backtail/JOVE/Panel/jove fp mask.png

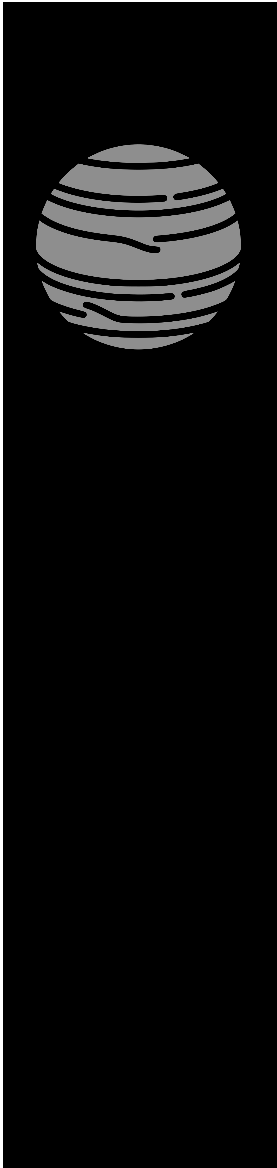
Panel/jove fp mask.png
