backtail/JOVE/Panel/jove fp silkscreen.png

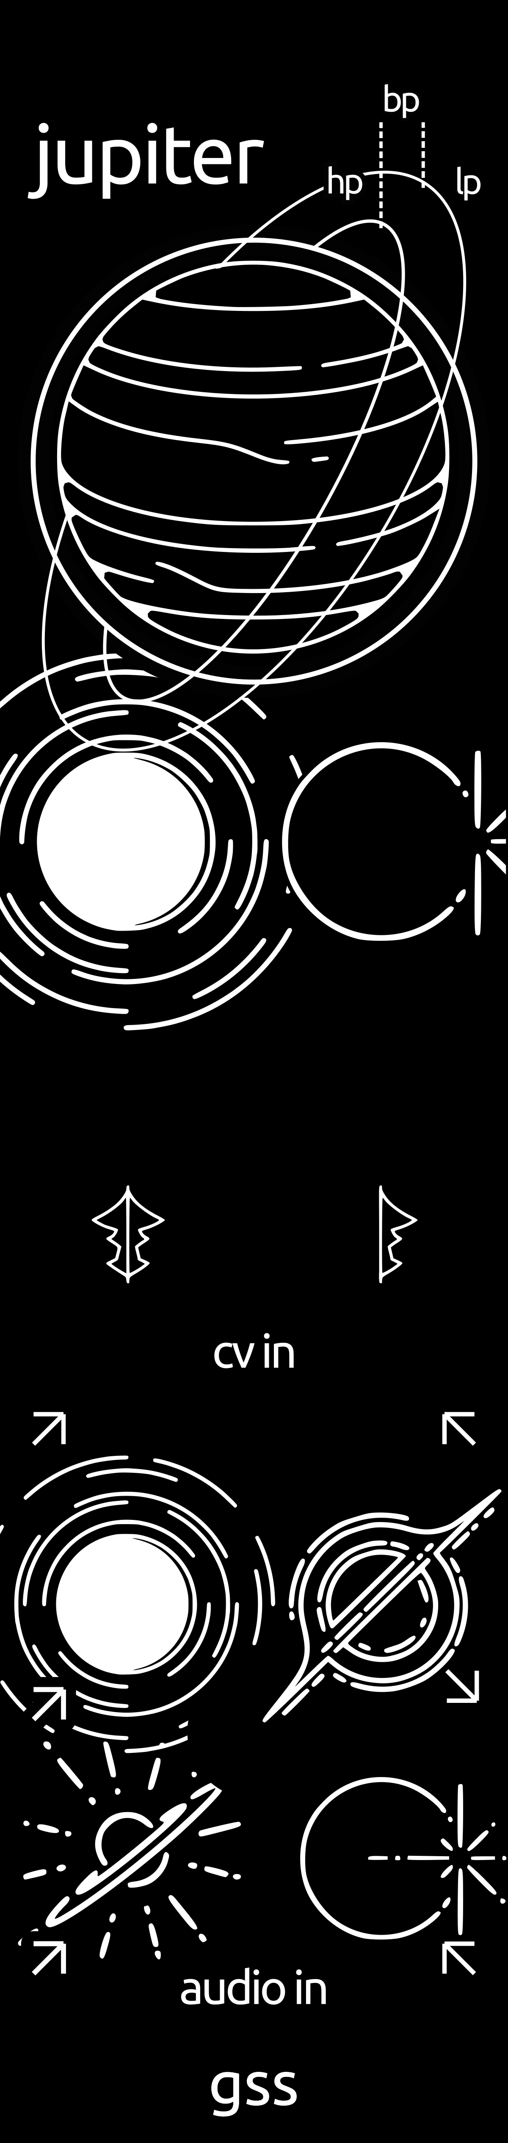
Panel/jove fp silkscreen.png
