backtail/JOVE/Panel/jove fp.png

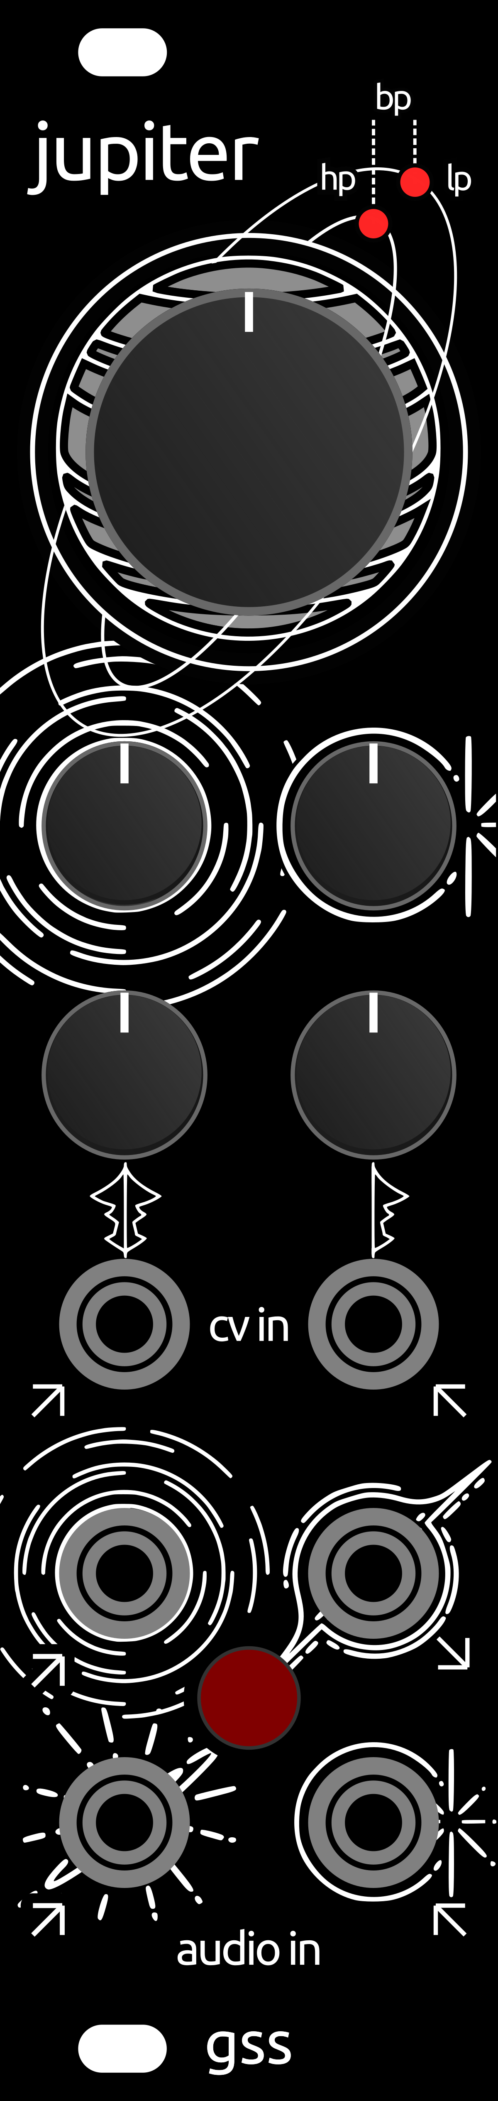
Panel/jove fp.png
