backtail/JOVE/Panel/jove.pdf

# jupiter

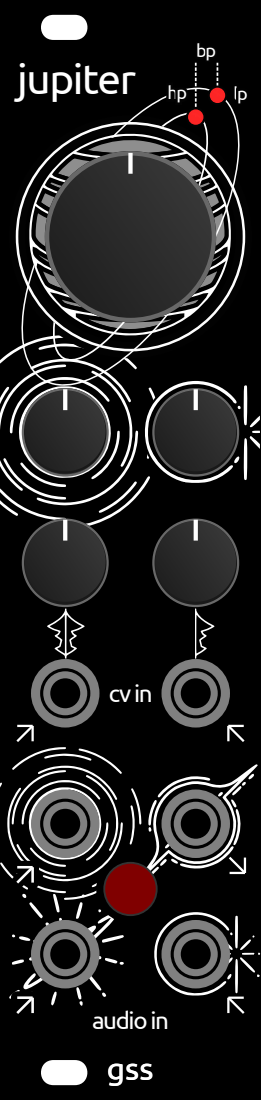
[picture p4: page 1]
gss; audio in
