backtail/JOVE/Jove.kicad_pcb

## KiCad design Jove.kicad_pcb (2024-10-23)

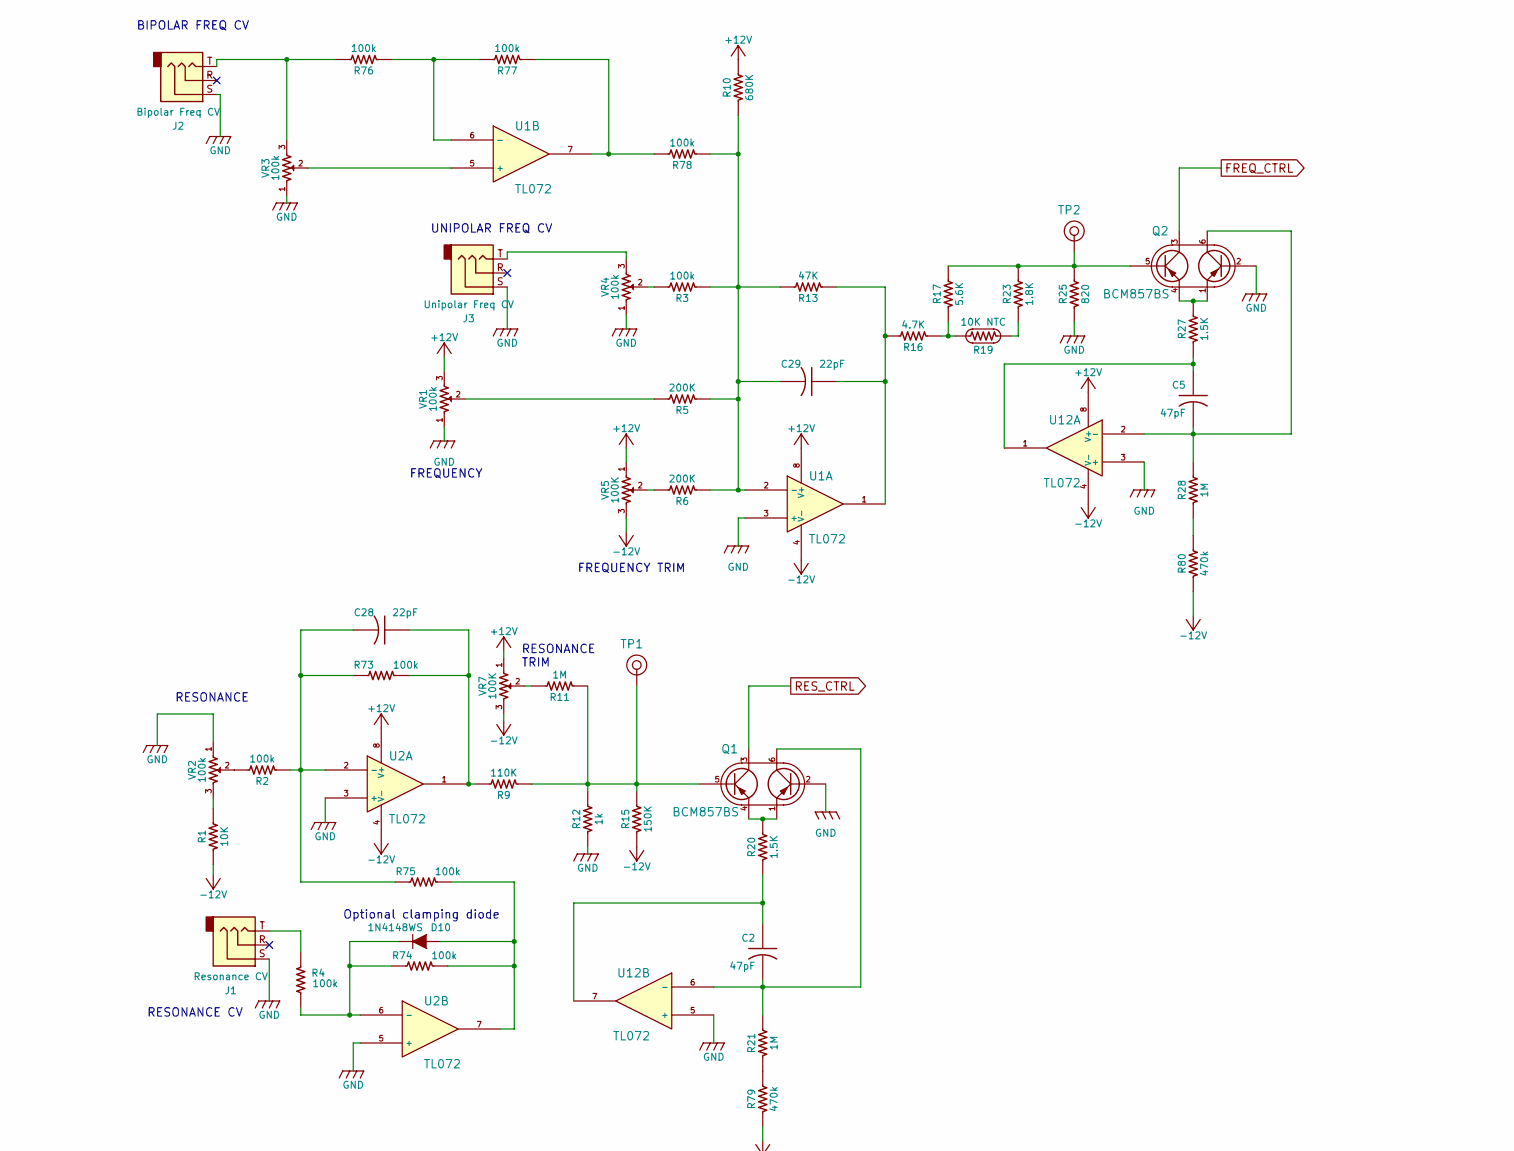
[picture p5: schematic Jove.kicad_sch, part in row 1, column 1]

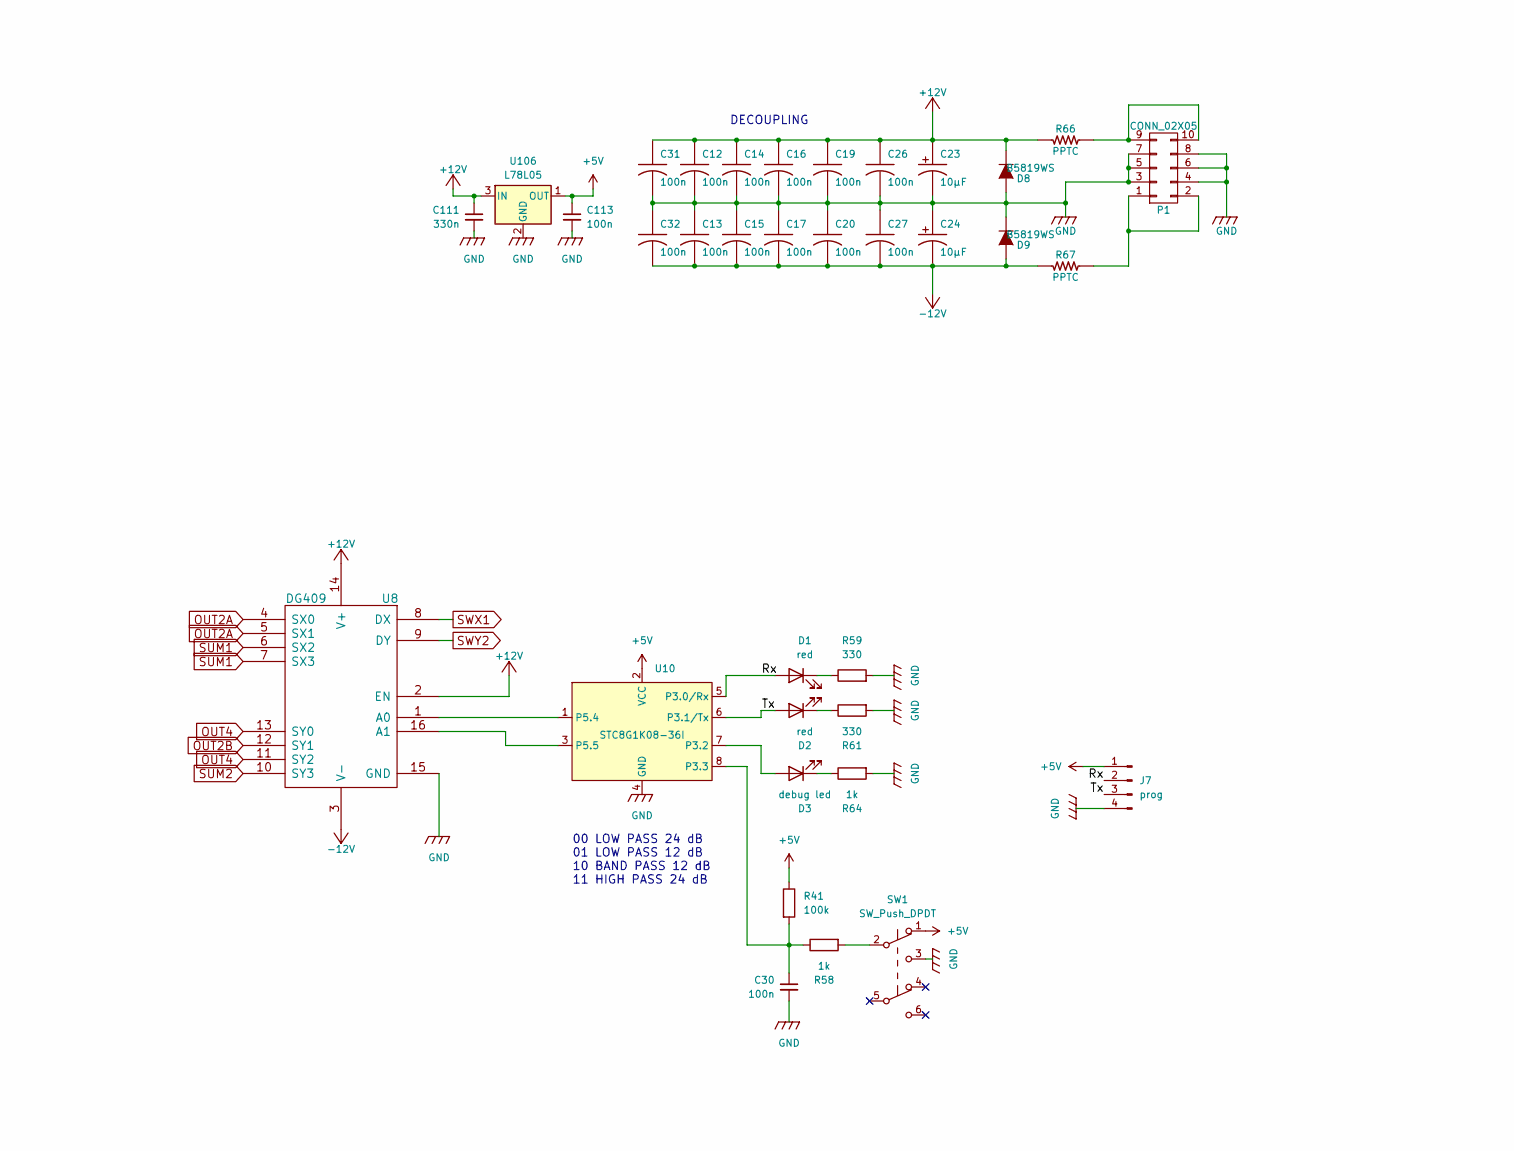
[picture p6: schematic Jove.kicad_sch, part in row 1, column 2]

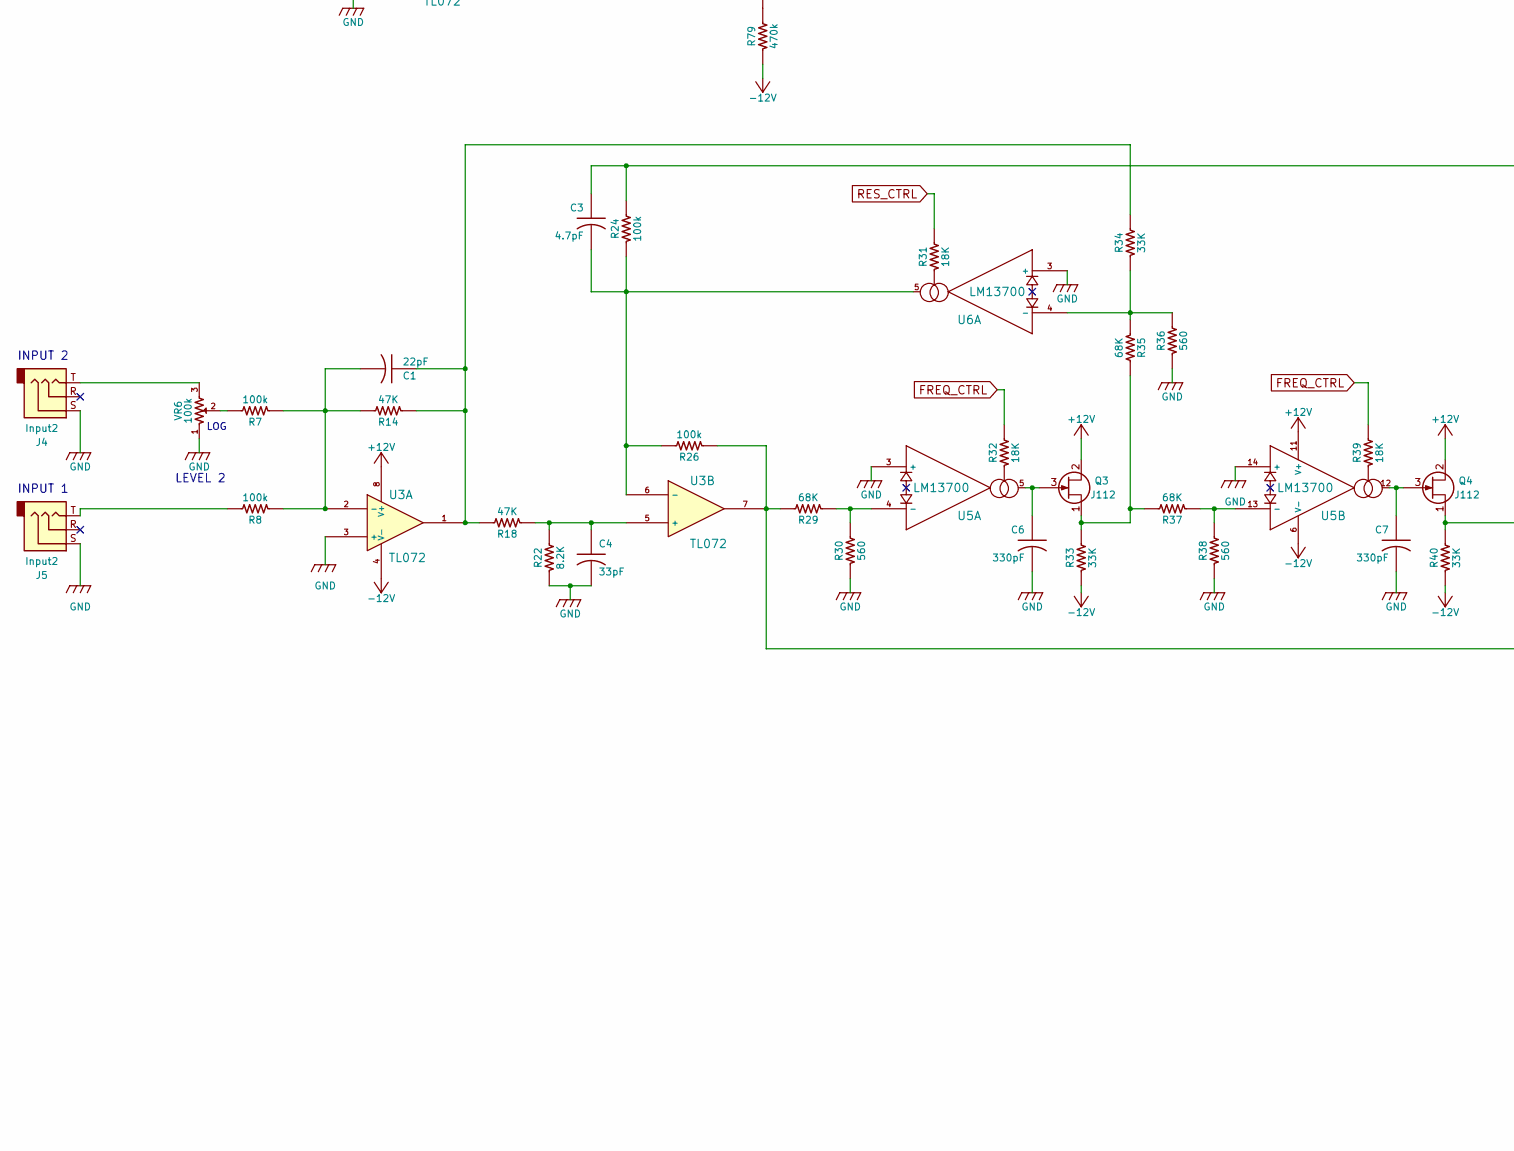
[picture p7: schematic Jove.kicad_sch, part in row 2, column 1]

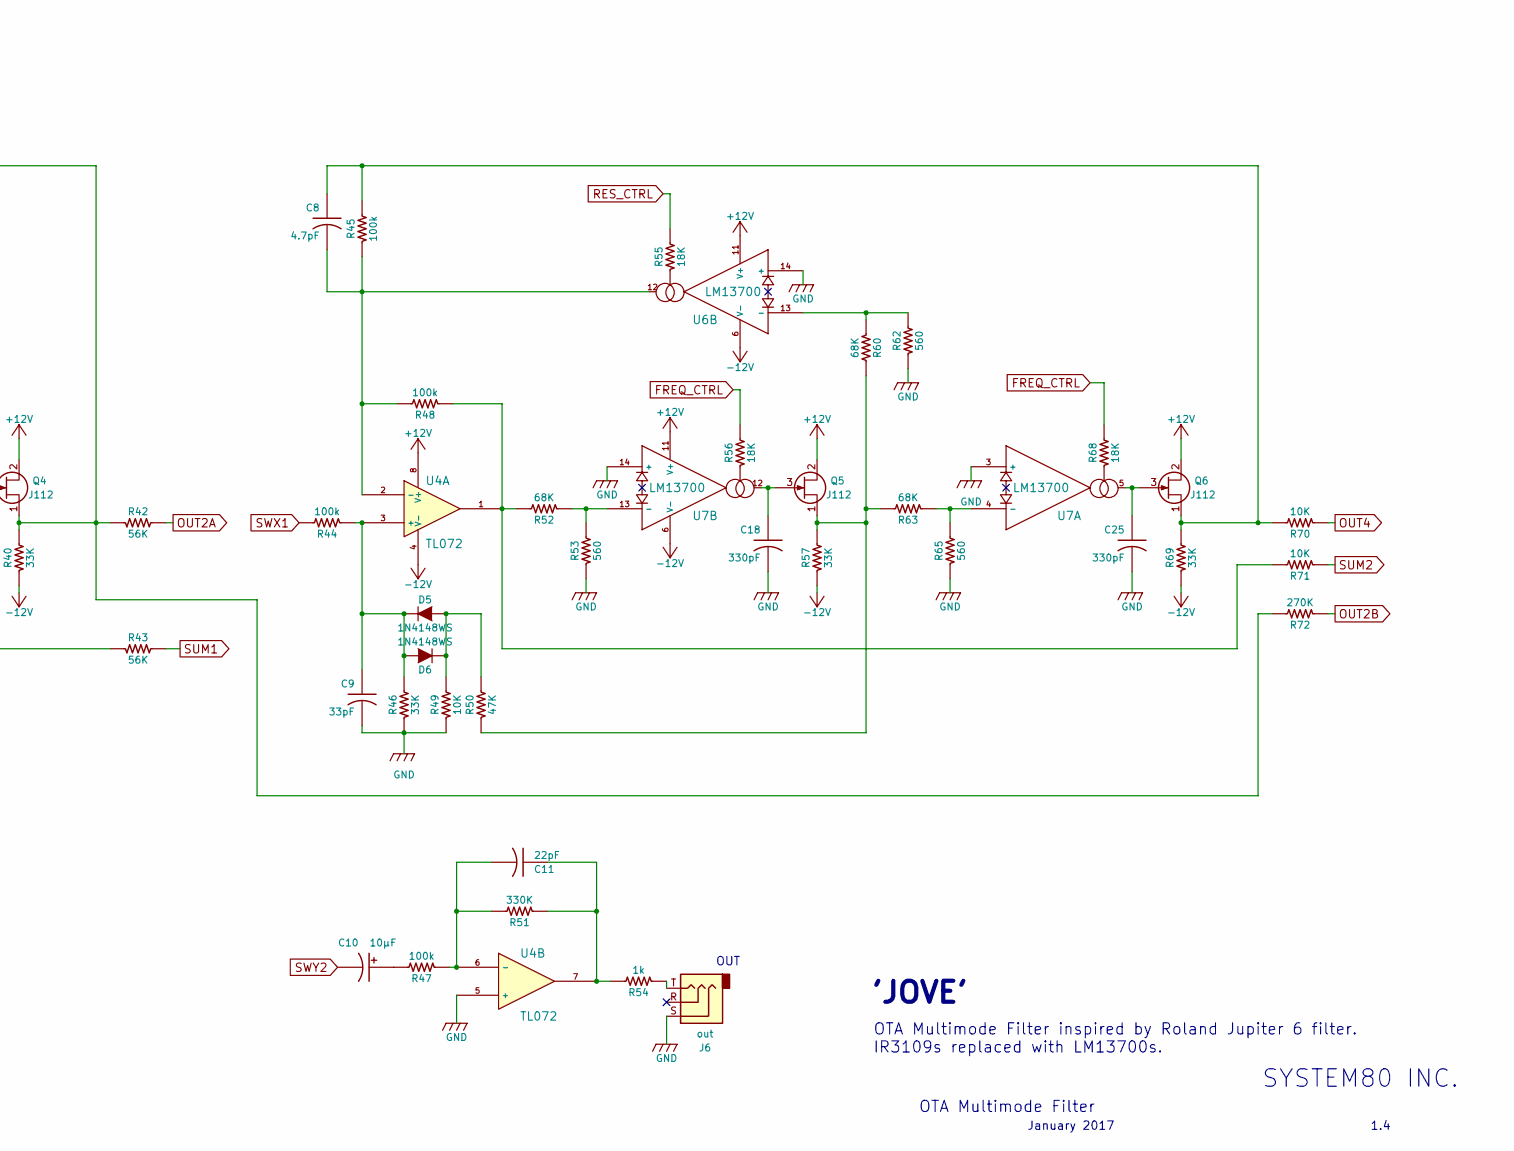
[picture p8: schematic Jove.kicad_sch, part in row 2, column 2]

Parts:
C1, C11, C28, C29: 22pF; C_0603_1608Metric; LCSC Part # C1653
C2, C5: 47pF; C_0603_1608Metric; LCSC Part # C1671
C3, C8: 4.7pF; C_0603_1608Metric; LCSC Part # C1669
C4, C9: 33pF; C_0603_1608Metric; LCSC Part # C1663
C6, C7, C18, C25: 330pF; C_0603_1608Metric; LCSC Part # C1664
C10, C23, C24: 10μF; CP_EIA-3216-18_Kemet-A; LCSC Part # C7171
C12, C13, C14, C15, C16, C17, C19, C20, C26, C27, C30, C31, C32, C113: 100n; C_0402_1005Metric; LCSC Part # C1525
C111: 330n; C_0603_1608Metric; LCSC Part # C1615
D1, D2: red; LED_D1.8mm_W3.3mm_H2.4mm
D3: debug led; D_0603_1608Metric; LCSC Part # C2286
D5, D6, D10: 1N4148WS; D_SOD-323; LCSC Part # C2128
D8, D9: B5819WS; D_SOD-323; LCSC Part # C7420331
J1: Resonance CV; Jack_3.5mm_PJ392_Vertical
J2: Bipolar Freq CV; Jack_3.5mm_PJ392_Vertical
J3: Unipolar Freq CV; Jack_3.5mm_PJ392_Vertical
J4, J5: Input2; Jack_3.5mm_PJ392_Vertical
J6: out; Jack_3.5mm_PJ392_Vertical
J7: prog; PinHeader_1x04_P2.54mm_Vertical
P1: CONN_02X05; Eurorack_10Pin; LCSC Part # C5383106
Q1, Q2: BCM857BS; SOT-363_SC-70-6; LCSC Part # C105887
Q3, Q4, Q5, Q6: J112; SOT-23; LCSC Part # C258195
R1, R49, R70, R71: 10K; R_0603_1608Metric; LCSC Part # C25804
R2, R3, R4, R7, R8, R24, R26, R41, R44, R45, R47, R48, R73, R74, R75, R76, R77, R78: 100k; R_0603_1608Metric; LCSC Part # C25803
R5, R6: 200K; R_0603_1608Metric; LCSC Part # C25811
R9: 110K; R_0603_1608Metric; LCSC Part # C25805
R10: 680K; R_0603_1608Metric; LCSC Part # C25822
R11, R21, R28: 1M; R_0603_1608Metric; LCSC Part # C22935
R12, R54, R58, R64: 1k; R_0603_1608Metric; LCSC Part # C21190
R13, R14, R18, R50: 47K; R_0603_1608Metric; LCSC Part # C25819
R15: 150K; R_0603_1608Metric; LCSC Part # C22807
R16: 4.7K; R_0603_1608Metric; LCSC Part # C23162
R17: 5.6K; R_0603_1608Metric; LCSC Part # C23189
R19: 10K NTC; R_0805_2012Metric; LCSC Part # C25804
R20, R27: 1.5K; R_0603_1608Metric; LCSC Part # C22843
R22: 8.2K; R_0603_1608Metric; LCSC Part # C25981
R23: 1.8K; R_0603_1608Metric; LCSC Part # C4177
R25: 820; R_0603_1608Metric; LCSC Part # C23253
R29, R35, R37, R52, R60, R63: 68K; R_0603_1608Metric; LCSC Part # C23231
R30, R36, R38, R53, R62, R65: 560; R_0603_1608Metric; LCSC Part # C23204
R31, R32, R39, R55, R56, R68: 18K; R_0603_1608Metric; LCSC Part # C25810
R33, R34, R40, R46, R57, R69: 33K; R_0603_1608Metric; LCSC Part # C4216
R42, R43: 56K; R_0603_1608Metric; LCSC Part # C23206
R51: 330K; R_0603_1608Metric; LCSC Part # C23137
R59, R61: 330; R_0603_1608Metric; LCSC Part # C23138
R66, R67: PPTC; R_1206_3216Metric; LCSC Part # C2649905
R72: 270K; R_0603_1608Metric; LCSC Part # C22965
R79, R80: 470k; R_0603_1608Metric; LCSC Part # C23178
SW1: SW_Push_DPDT; SW_5.8x5.8mm
TP1, TP2: TEST_POINT; TestPoint_Pad_2.5x2.5mm
U1, U2, U3, U4, U12: TL072; SOIC-8_3.9x4.9mm_P1.27mm; LCSC Part # C6961
U5, U6, U7: LM13700; SOIC-16_3.9x9.9mm_P1.27mm; LCSC Part # C521166
U8: DG409; SOIC-16_3.9x9.9mm_P1.27mm; LCSC Part # C142533
U10: STC8G1K08-36I; SOIC-8_3.9x4.9mm_P1.27mm; LCSC Part # C713818
U106: L78L05; SOT-89-3; LCSC Part # C71136
VR1, VR2, VR3, VR4, VR6: 100k; Potentiometer_RK09_RV09_Vertical
VR5, VR7: 100K; Potentiometer_Bourns_TC33X_Vertical; LCSC Part # C128545

Connections:
+5V: J7.1, R41.1, SW1.1 (A), U10.2 (VCC); also elsewhere on the board
+12V: C12.1, C14.1, C16.1, C19.1, C23.1 (+), C26.1, C31.1, D8.1 (K), Q3.2 (D), Q4.2 (D), Q5.2 (D), Q6.2 (D), R10.2, R66.1, U1.8 (V+), U2.8 (V+), U3.8 (V+), U4.8 (V+), U5.11 (V+), U6.11 (V+), U7.11 (V+), U8.2 (EN), U8.14 (V+), U12.8 (V+), VR1.3, VR5.1, VR7.1; also elsewhere on the board
-12V: C13.2, C15.2, C17.2, C20.2, C24.2 (-), C27.2, C32.2, D9.2 (A), R1.2, R15.2, R33.1, R40.1, R57.1, R67.1, R69.1, R79.2, R80.2, U1.4 (V-), U2.4 (V-), U3.4 (V-), U4.4 (V-), U5.6 (V-), U6.6 (V-), U7.6 (V-), U8.3 (V-), U12.4 (V-), VR5.3, VR7.3
/Rx: D1.2 (A), J7.2, U10.5 (P3.0/Rx)
/Tx: D2.2 (A), J7.3, U10.6 (P3.1/Tx)
FREQ_CTRL: Q2.3 (C2), R32.2, R39.2, R56.2, R68.2
GND: C4.2, C6.2, C7.2, C9.2, C12.2, C13.1, C14.2, C15.1, C16.2, C17.1, C18.2, C19.2, C20.1, C23.2 (-), C24.1 (+), C25.2, C26.2, C27.1, C30.2, C31.2, C32.1, D8.2 (A), D9.1 (K), J1.S, J2.S, J3.S, J4.S, J5.S, J6.S, J7.4, P1.3, P1.4, P1.5, P1.6, P1.7, P1.8, Q1.2 (B1), Q2.2 (B1), R12.2, R22.1, R25.1, R30.1, R36.1, R38.1, R46.1, R49.1, R53.1, R59.2, R61.2, R62.1, R64.2, R65.1, SW1.3 (C), U1.3 (+), U2.3 (+), U2.5 (+), U3.3 (+), U4.5 (+), U5.3 (+), U5.14 (+), U6.3 (+), U6.14 (+), U7.3 (+), U7.14 (+), U8.15 (GND), U10.4 (GND), U12.3 (+), U12.5 (+), VR1.1, VR2.1, VR3.1, VR4.1, VR6.1; also elsewhere on the board
unnamed: C1.1, R14.1, R18.2, R34.2, U3.1
unnamed: C2.1, R20.2, U12.7
unnamed: C5.1, R27.2, U12.1
unnamed: C10.1 (+), R47.2
unnamed: C11.1, R51.1, R54.2, U4.7
unnamed: C28.1, R9.2, R73.1, U2.1
unnamed: C29.1, R13.1, R16.2, U1.1
unnamed: D1.1 (K), R59.1
unnamed: D2.1 (K), R61.1
unnamed: D3.2 (A), U10.7 (P3.2)
unnamed: D3.1 (K), R64.1
unnamed: D5.2 (A), D6.1 (K), R49.2, R50.2
unnamed: C9.1, D5.1 (K), D6.2 (A), R44.1, R46.2, U4.3 (+)
unnamed: D10.2 (A), R74.1, R75.1, U2.7
unnamed: D10.1 (K), R4.1, R74.2, U2.6 (-)
unnamed: J1.T, R4.2
unnamed: J2.T, R76.2, VR3.3
unnamed: J3.T, VR4.3
unnamed: J4.T, VR6.3
unnamed: J5.T, R8.2
unnamed: J6.T, R54.1
unnamed: P1.1, P1.2, R67.2
unnamed: P1.9, P1.10, R66.2
unnamed: Q1.5 (B2), R9.1, R11.1, R12.1, R15.1, TP1.1
unnamed: C2.2, Q1.6 (C1), R21.1, U12.6 (-)
unnamed: Q1.1 (E1), Q1.4 (E2), R20.1
unnamed: Q2.5 (B2), R17.2, R23.2, R25.2, TP2.1
unnamed: C5.2, Q2.6 (C1), R28.1, U12.2 (-)
unnamed: Q2.1 (E1), Q2.4 (E2), R27.1
unnamed: C6.1, Q3.3 (G), U5.5
unnamed: Q3.1 (S), R33.2, R35.2, R37.2
unnamed: C7.1, Q4.3 (G), U5.12
unnamed: C3.1, Q4.1 (S), R24.2, R40.2, R42.2, R72.2
unnamed: C18.1, Q5.3 (G), U7.12
unnamed: Q5.1 (S), R50.1, R57.2, R60.2, R63.2
unnamed: C25.1, Q6.3 (G), U7.5
unnamed: C8.1, Q6.1 (S), R45.2, R69.2, R70.2
unnamed: R1.1, VR2.3
unnamed: R2.2, VR2.2
unnamed: R3.2, VR4.2
unnamed: R5.2, VR1.2
unnamed: R6.2, VR5.2
unnamed: R7.2, VR6.2
unnamed: R11.2, VR7.2
unnamed: R16.1, R17.1, R19.2
unnamed: R19.1, R23.1
unnamed: R21.2, R79.1
unnamed: R26.1, R29.2, R43.2, U3.7
unnamed: R28.2, R80.1
unnamed: R31.1, U6.1
unnamed: R32.1, U5.1
unnamed: R39.1, U5.16
unnamed: R48.1, R52.2, R71.2, U4.1
unnamed: R55.1, U6.16
unnamed: R56.1, U7.16
unnamed: R58.2, SW1.2 (B)
unnamed: R68.1, U7.1
unnamed: R77.1, R78.2, U1.7
unnamed: C29.2, R3.1, R5.1, R6.1, R10.1, R13.2, R78.1, U1.2 (-)
unnamed: U1.5 (+), VR3.2
unnamed: R76.1, R77.2, U1.6 (-)
unnamed: C28.2, R2.1, R73.2, R75.2, U2.2 (-)
unnamed: C1.2, R7.1, R8.1, R14.2, U3.2 (-)
unnamed: C4.1, R18.1, R22.2, U3.5 (+)
unnamed: C3.2, R24.1, R26.2, U3.6 (-), U6.5
unnamed: C8.2, R45.1, R48.2, U4.2 (-), U6.12
unnamed: C11.2, R47.1, R51.2, U4.6 (-)
unnamed: R29.1, R30.2, U5.4 (-)
unnamed: R37.1, R38.2, U5.13 (-)
unnamed: R34.1, R35.1, R36.2, U6.4 (-)
unnamed: R60.1, R62.2, U6.13 (-)
unnamed: R63.1, R65.2, U7.4 (-)
unnamed: R52.1, R53.2, U7.13 (-)
unnamed: C30.1, R41.2, R58.1, U10.8 (P3.3)
unnamed: U8.1 (A0), U10.1 (P5.4)
unnamed: U8.16 (A1), U10.3 (P5.5)
OUT2A: R42.1, U8.4 (SX0), U8.5 (SX1)
OUT2B: R72.1, U8.12 (SY1)
OUT4: R70.1, U8.11 (SY2), U8.13 (SY0)
RES_CTRL: Q1.3 (C2), R31.2, R55.2
SUM1: R43.1, U8.6 (SX2), U8.7 (SX3)
SUM2: R71.1, U8.10 (SY3)
SWX1: R44.2, U8.8 (DX)
SWY2: C10.2 (-), U8.9 (DY)

Notes on the sheet:
DECOUPLING
OUT
'JOVE'
BIPOLAR FREQ CV
OTA Multimode Filter
UNIPOLAR FREQ CV
LOG
RESONANCE CV
LEVEL 2
1.4
Optional clamping diode
FREQUENCY
RESONANCE
00 LOW PASS 24 dB 01 LOW PASS 12 dB 10 BAND PASS 12 dB 11 HIGH PASS 24 dB
OTA Multimode Filter inspired by Roland Jupiter 6 filter. IR3109s replaced with LM13700s.
RESONANCE TRIM
FREQUENCY TRIM
January 2017
INPUT 1
INPUT 2
SYSTEM80 INC.

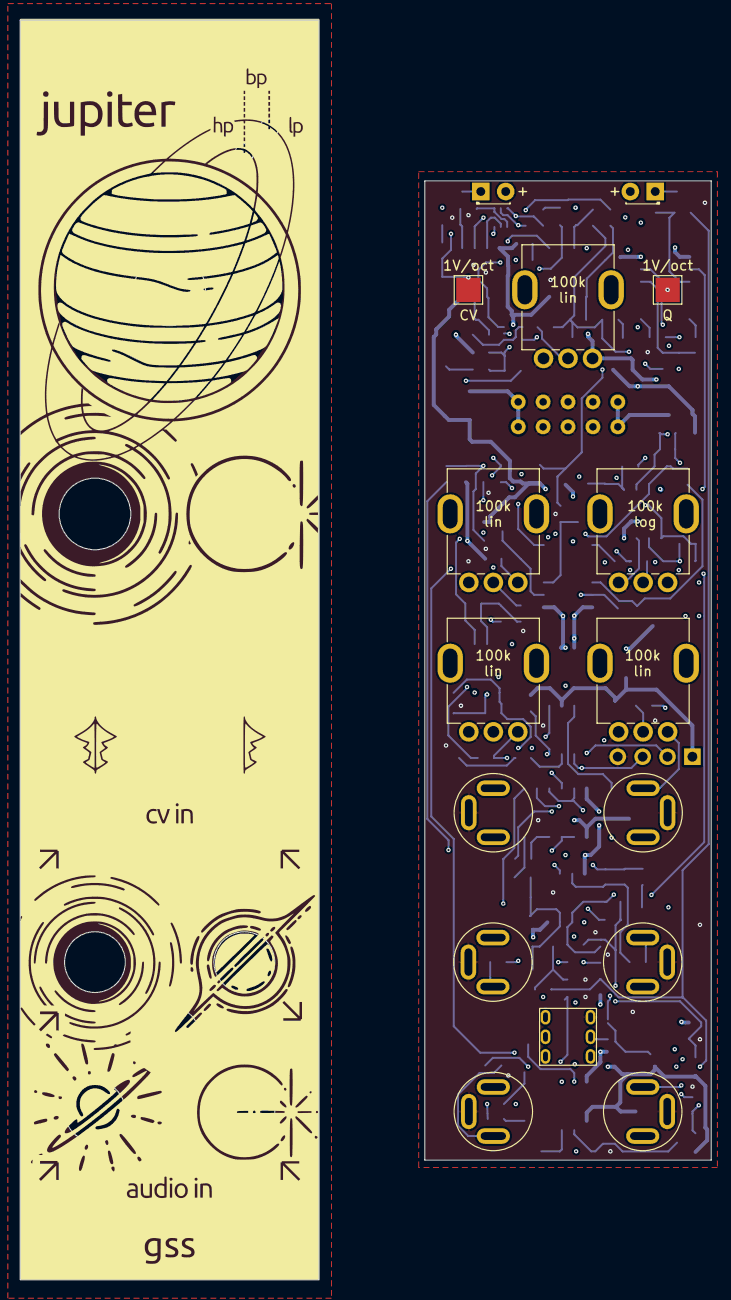
[picture p9: board Jove.kicad_pcb from above]

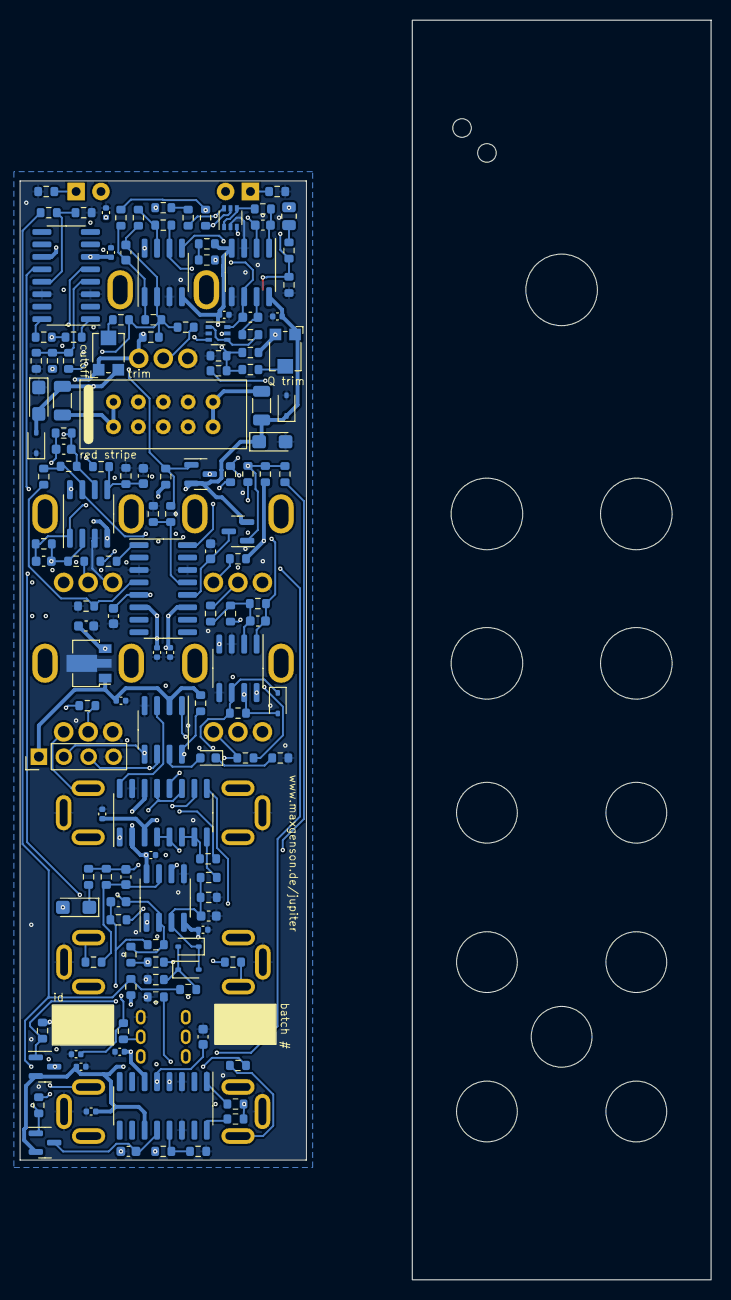
[picture p10: board Jove.kicad_pcb from below]

Board: 4 copper layers, 29.2 x 99.9 mm, 155 parts (139 on the bottom side), 91 nets.

Other parts of the board:
C21: 330n; C_0603_1608Metric
C22: 100n; C_0402_1005Metric
U9: L78L05; SOT-89-3

Their connections:
+5V: C22.1, U9.1 (OUT); also elsewhere on the board
+12V: C21.1, U9.3 (IN); also elsewhere on the board
GND: C21.2, C22.2, U9.2 (GND); also elsewhere on the board
