backtail/JOVE/(commit log)

2024-02-12 redesign PCB
    [JOVE_BOM.csv, Jove.kicad_pcb, Jove.kicad_sch]
2024-02-12 redesign Frontpanel
    [Jove_panel_drill_holes.dxf]
2024-02-12 add gerbers
    [bom.csv, designators.csv, positions.csv]
2024-02-21 ordered fixed frontpanels
    [Jove.kicad_pcb]
2024-10-23 add batch 2 changes
    [Jove.kicad_pcb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]
